yholinocomun/robotfun_ws/src/robotfun_description/meshes/arm/eslabon3_link.stl

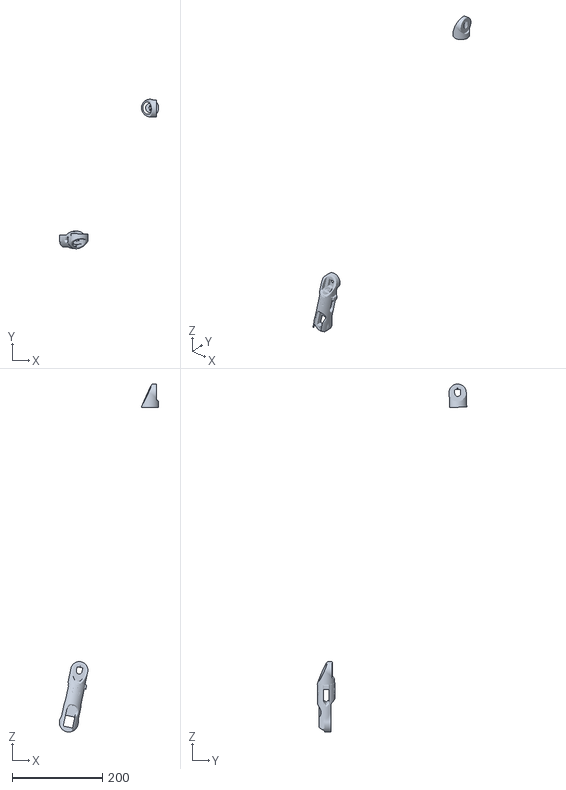
[picture p1: CAD file, 2026-06-30]
src/robotfun_description/meshes/arm/eslabon3_link.stl
219.9 x 331.1 x 770.3
