yholinocomun/robotfun_ws/src/robotfun_description/meshes/gripper/right_gripper.stl

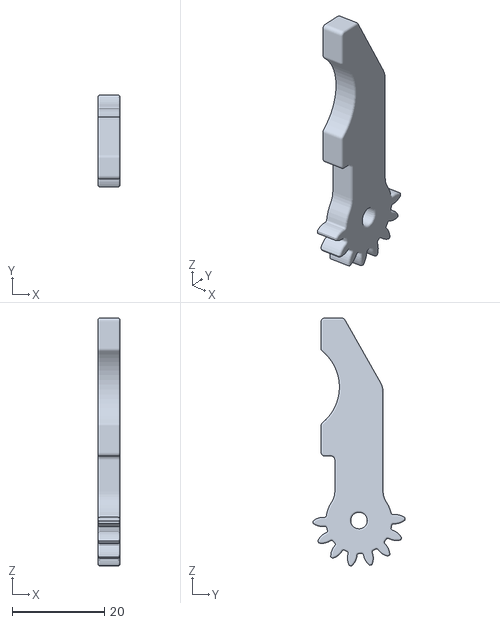
[picture p2: CAD file, 2026-06-30]
src/robotfun_description/meshes/gripper/right_gripper.stl
4.80 x 20.0 x 53.9
