yholinocomun/robotfun_ws/src/robotfun_description/meshes/arm/eslabon4_link.stl

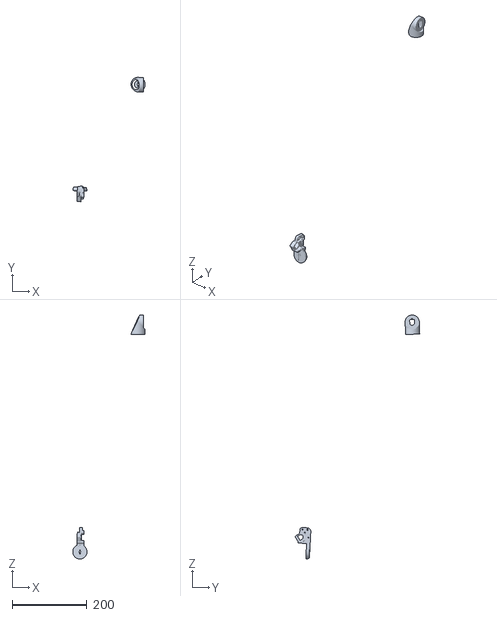
[picture p3: CAD file, 2026-06-30]
src/robotfun_description/meshes/arm/eslabon4_link.stl
193.6 x 332.6 x 651.7
