yholinocomun/robotfun_ws/src/robotfun_description/meshes/arm/base_link.stl

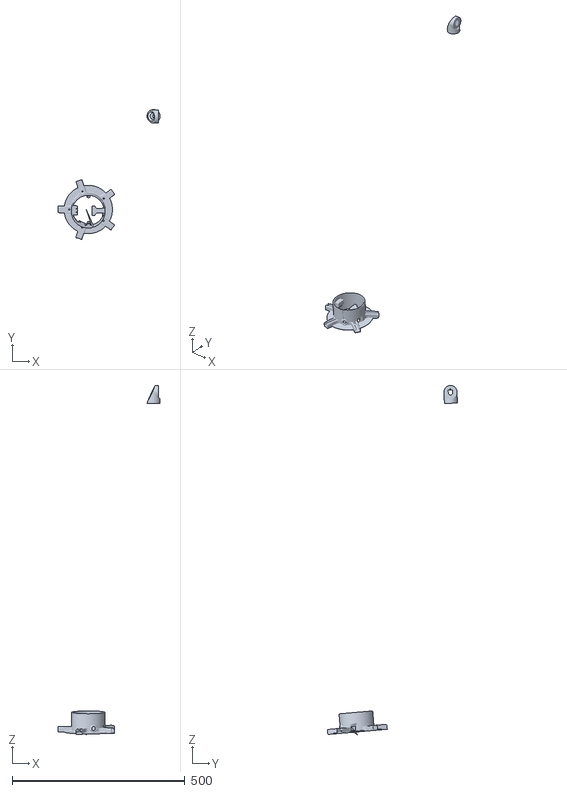
[picture p4: CAD file, 2026-06-30]
src/robotfun_description/meshes/arm/base_link.stl
296.0 x 376.2 x 1010.3
