yholinocomun/robotfun_ws/src/robotfun_description/meshes/arm/eslabon2_link.stl

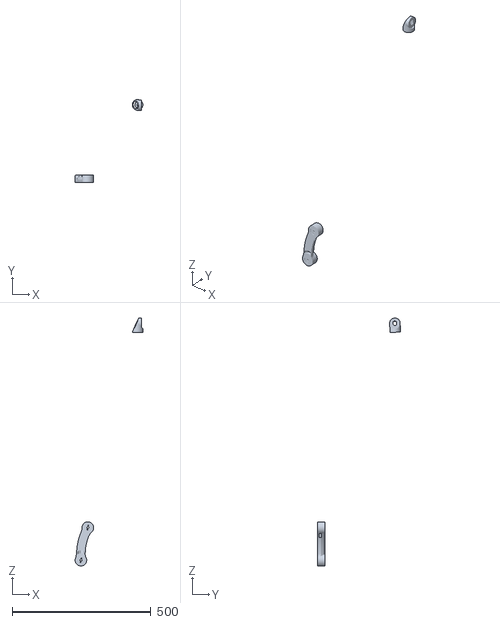
[picture p5: CAD file, 2026-06-30]
src/robotfun_description/meshes/arm/eslabon2_link.stl
244.3 x 299.2 x 894.1
