yholinocomun/robotfun_ws/src/robotfun_description/meshes/arm/eslabon1_link.stl

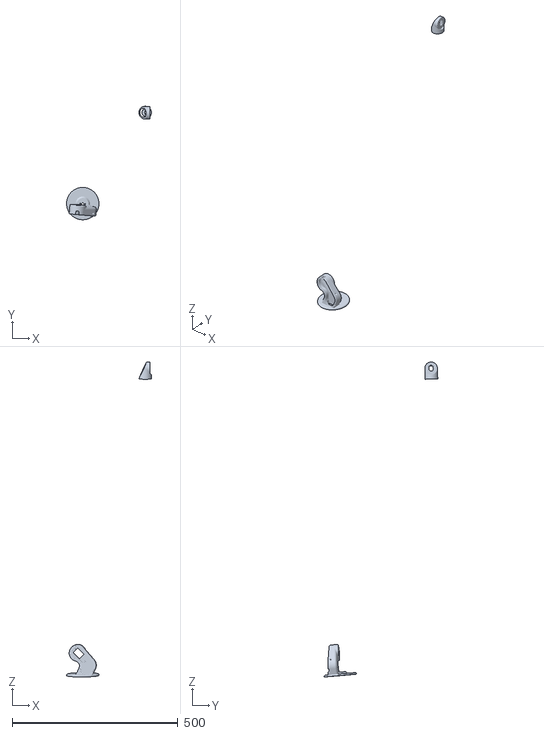
[picture p6: CAD file, 2026-06-30]
src/robotfun_description/meshes/arm/eslabon1_link.stl
256.5 x 343.2 x 951.4
