yholinocomun/robotfun_ws/(list of files, cad)

Other CAD files:
src/robotfun_description/meshes/gripper/left_gripper.stl
