yholinocomun/robotfun_ws/src/robotfun_description/urdf/common/arm.macro.xacro

<?xml version="1.0"?>
<!-- ============================================================================
     arm.macro.xacro  —  esqueleto PRIMITIVO (tabla DH del usuario)
     ===========================================================================
     Brazo 4 GDL RECTO dibujado con PRIMITIVAS dimensionadas a la tabla DH:
         L0=0.010 (offset base)  L1=0.063  L2=0.120  A3=0.120  HAND=0.11  [m]
     Reproduce EXACTAMENTE la FK del núcleo (TF == FK). Es el modelo para
     VERIFICAR el DH y la cinemática inversa.  FK(HOME) → TCP=[0.010, 0, 0.413].

     Ejes: joint_1=(0 0 1) yaw; joint_2/3/4=(0 -1 0) pitch. tool0 = frame (sin cubo).
     ========================================================================== -->
<robot xmlns:xacro="http://www.ros.org/wiki/xacro">

  <xacro:property name="lo" value="-1.5708"/>   <!-- −90° (HOME=0 ⇒ servo a 90°) -->
  <xacro:property name="hi" value="1.5708"/>    <!-- +90° -->

  <xacro:macro name="robotfun_arm">

    <link name="world"/>
    <joint name="base_joint" type="fixed">
      <origin xyz="0 0 0" rpy="0 0 0"/><parent link="world"/><child link="base_link"/>
    </joint>

    <!-- base_link (soporte fijo) -->
    <link name="base_link">
      <inertial><mass value="1.0"/>
        <inertia ixx="0.01" ixy="0" ixz="0" iyy="0.01" iyz="0" izz="0.01"/></inertial>
      <visual>
        <origin xyz="0 0 0.015" rpy="0 0 0"/>
        <geometry><cylinder radius="0.045" length="0.03"/></geometry>
        <material name="grey"/>
      </visual>
    </link>

    <!-- joint_1 yaw (en la base) -->
    <joint name="joint_1" type="revolute">
      <origin xyz="0 0 0" rpy="0 0 0"/><parent link="base_link"/><child link="link_1"/>
      <axis xyz="0 0 1"/><limit lower="${lo}" upper="${hi}" effort="10.0" velocity="1.5"/>
    </joint>

    <!-- link_1: columna de yaw hasta el hombro (L0 radial, L1 alto) -->
    <link name="link_1">
      <inertial><origin xyz="0.005 0 0.032"/><mass value="0.5"/>
        <inertia ixx="1e-3" ixy="0" ixz="0" iyy="1e-3" iyz="0" izz="1e-3"/></inertial>
      <visual>
        <origin xyz="0.005 0 0.032" rpy="0 0.156 0"/>
        <geometry><cylinder radius="0.022" length="0.064"/></geometry>
        <material name="black"/>
      </visual>
    </link>

    <!-- joint_2 hombro: offset radial L0=0.010, alto L1=0.063 -->
    <joint name="joint_2" type="revolute">
      <origin xyz="0.010 0 0.063" rpy="0 0 0"/><parent link="link_1"/><child link="link_2"/>
      <axis xyz="0 -1 0"/><limit lower="${lo}" upper="${hi}" effort="10.0" velocity="1.5"/>
    </joint>

    <!-- link_2: brazo L2=0.120 -->
    <link name="link_2">
      <inertial><origin xyz="0 0 0.06"/><mass value="0.4"/>
        <inertia ixx="1e-3" ixy="0" ixz="0" iyy="1e-3" iyz="0" izz="1e-3"/></inertial>
      <visual>
        <origin xyz="0 0 0.060" rpy="0 0 0"/>
        <geometry><cylinder radius="0.018" length="0.120"/></geometry>
        <material name="red"/>
      </visual>
    </link>

    <joint name="joint_3" type="revolute">
      <origin xyz="0 0 0.120" rpy="0 0 0"/><parent link="link_2"/><child link="link_3"/>
      <axis xyz="0 -1 0"/><limit lower="${lo}" upper="${hi}" effort="10.0" velocity="1.5"/>
    </joint>

    <!-- link_3: antebrazo A3=0.120 -->
    <link name="link_3">
      <inertial><origin xyz="0 0 0.06"/><mass value="0.3"/>
        <inertia ixx="8e-4" ixy="0" ixz="0" iyy="8e-4" iyz="0" izz="8e-4"/></inertial>
      <visual>
        <origin xyz="0 0 0.060" rpy="0 0 0"/>
        <geometry><cylinder radius="0.015" length="0.120"/></geometry>
        <material name="blue"/>
      </visual>
    </link>

    <joint name="joint_4" type="revolute">
      <origin xyz="0 0 0.120" rpy="0 0 0"/><parent link="link_3"/><child link="link_4"/>
      <axis xyz="0 -1 0"/><limit lower="${lo}" upper="${hi}" effort="10.0" velocity="1.5"/>
    </joint>

    <!-- link_4: mano HAND=0.11 (muñeca → punta) -->
    <link name="link_4">
      <inertial><origin xyz="0 0 0.055"/><mass value="0.2"/>
        <inertia ixx="5e-4" ixy="0" ixz="0" iyy="5e-4" iyz="0" izz="5e-4"/></inertial>
      <visual>
        <origin xyz="0 0 0.055" rpy="0 0 0"/>
        <geometry><cylinder radius="0.013" length="0.110"/></geometry>
        <material name="black"/>
      </visual>
    </link>

    <!-- tool0 = TCP (punta del gripper). Solo frame, sin cubo. -->
    <joint name="tool_fixed" type="fixed">
      <origin xyz="0 0 0.110" rpy="0 0 0"/><parent link="link_4"/><child link="tool0"/>
    </joint>
    <link name="tool0"/>

  </xacro:macro>
</robot>
