yholinocomun/robotfun_ws/src/robotfun_description/urdf/common/gripper.macro.xacro

<?xml version="1.0"?>
<!-- ============================================================================
     gripper.macro.xacro
       * gripper_primitive : gripper de 1 GDL con dedos finos de caja; se mueve con
         el joint "joint_5" (el 5º actuador, físicamente el gripper) para el modelo
         de medidas reales. Sin el cubo anterior.
     ========================================================================== -->
<robot xmlns:xacro="http://www.ros.org/wiki/xacro">

  <!-- ===== PRIMITIVO (móvil) ===== -->
  <xacro:macro name="gripper_primitive" params="parent *origin">
    <joint name="joint_5" type="revolute">
      <xacro:insert_block name="origin"/>
      <parent link="${parent}"/><child link="gripper_finger_left"/>
      <axis xyz="0 1 0"/>
      <!-- rango 0..70° (1.22 rad), igual que el firmware/command; asi RViz no recorta -->
      <limit effort="5.0" lower="0.0" upper="1.22" velocity="2.0"/>
    </joint>
    <link name="gripper_finger_left">
      <inertial><mass value="0.01"/>
        <inertia ixx="1e-6" ixy="0" ixz="0" iyy="1e-6" iyz="0" izz="1e-6"/></inertial>
      <visual>
        <origin xyz="0.012 0 0.018" rpy="0 0 0"/>
        <geometry><box size="0.006 0.012 0.036"/></geometry>
        <material name="red"/>
      </visual>
    </link>
    <joint name="joint_5_right" type="revolute">
      <xacro:insert_block name="origin"/>
      <parent link="${parent}"/><child link="gripper_finger_right"/>
      <axis xyz="0 1 0"/>
      <limit effort="5.0" lower="-1.22" upper="0.0" velocity="2.0"/>
      <mimic joint="joint_5" multiplier="-1.0"/>
    </joint>
    <link name="gripper_finger_right">
      <inertial><mass value="0.01"/>
        <inertia ixx="1e-6" ixy="0" ixz="0" iyy="1e-6" iyz="0" izz="1e-6"/></inertial>
      <visual>
        <origin xyz="-0.012 0 0.018" rpy="0 0 0"/>
        <geometry><box size="0.006 0.012 0.036"/></geometry>
        <material name="red"/>
      </visual>
    </link>
  </xacro:macro>

</robot>
