yholinocomun/robotfun_ws/(commit log)

2026-05-17 creando . urdf y .launch del robotfun
    [robotfun.urdf]
2026-06-30 robotfun_kinematics: núcleo DH puro + nodos ROS (IK J4 fijo/activo)
    Núcleo sin ROS (Clean Architecture):
    - core/dh_model.py: tabla DH validada (FK(HOME)=[0.010,0,0.393]), FK, Jacobiano
    geométrico 6x5. DHChain encapsula la tabla (SOLID).
    - core/ik_solver.py: IK por DLS (Levenberg-Marquardt) con máscara de juntas
    activas. Una sola implementación cubre las DOS versiones: J4 fijo (4 GDL,
    pick&place, bien condicionada) y J4 activo (5 GDL). Utilidades de orientación.
    - core/trajectory.py: perfil trapezoidal (servos de posición, lazo abierto).
    Nodos ROS (adaptadores delgados):
    - ik_node: /target_pose -> IK -> /joint_command (param use_joint4).
    - fk_check_node: /joint_states -> FK -> /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
2026-06-30 robotfun_description: brazo 5 GDL + gripper (primitivas DH-exactas y meshes reales)
    Reemplaza el placeholder (robot móvil) por el brazo real. Dos modelos sin
    conflicto, misma interfaz de juntas (joint_1..joint_5 + gripper):
    - robotfun.urdf.xacro (CANÓNICO): generado desde la tabla DH validada con
    scripts/generate_dh_origins.py; verificado TF == FK a 1e-6 sobre el URDF
    expandido. Incluye <collision> e <inertial> (listo para Gazebo/MoveIt2).
    - robotfun_meshes.urdf.xacro: repara el brazo.urdf original (renombra juntas,
    elimina engranajes con meshes inexistentes y rpy en grados, satura límites a
    ±90°) y monta el gripper real rescatado de twin_ws.
    - common/: materials.xacro y grippe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
    [base_link.stl, eslabon1_link.stl, eslabon2_link.stl, eslabon3_1link.stl, eslabon3_link.stl, eslabon4_link.stl, gripper.macro.xacro, joint_limits.yaml]
2026-06-30 robotfun_firmware: ESP32 micro-ROS 5 GDL + gripper (dos versiones por #define)
    Refactor del firmware base con buenas prácticas:
    - #define USE_JOINT4 1|0: una sola base de código, dos versiones (DRY). 1 = J4
    activo (5 GDL); 0 = J4 anulado (servo de J4 fijo en HOME, q4=0, 4 GDL para
    pick&place). Gemelo del parámetro use_joint4 del alto nivel.
    - Radianes en el bus ROS (REP-103); conversión a grados solo en servo.write().
    Calibración expresada en grados/ADC (intuitiva del hardware).
    - Rango articular POR CANAL (el gripper usa su propio rango, ya no ±90° global).
    - Estructura clara, utilidades clampf/adc_to_rad/rad_to_servo_deg, nombres de
    junta consistentes con el URDF y el núcle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
2026-06-30 robotfun_bringup + README: composition root y documentación de arquitectura
    - launch/bringup.launch.py: compone descripción + cinemática (args model,
    use_joint4, controller, gui).
    - docs/ARCHITECTURE.md: capas (Clean Architecture/SOLID), flujo de datos, modelo
    DH, y las decisiones técnicas (J4 fijo por defecto; radianes en bus/grados en
    servo; control trapezoidal). Documenta la inconsistencia DH<->URDF de twin_ws
    ya corregida aquí.
    - docs/ROADMAP.md: fases hacia el pick&place con cámara (Gazebo, MoveIt2,
    percepción QR/color) sin romper la fuente de verdad.
    - README del workspace con guía de uso y las respuestas a J4 y grados/radianes.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
2026-06-30 fix(description): envolver robot_description en ParameterValue(value_type=str)
    En ROS 2 Humble, pasar la salida de `xacro` (Command) directamente como
    parámetro hace que launch intente parsear el XML como YAML y falle con
    "Unable to parse the value of parameter robot_description as yaml".
    Se envuelve en launch_ros ParameterValue(..., value_type=str). Afecta a
    display.launch.py (y por tanto a bringup.launch.py que lo incluye).
    Claude-Session: https://claude.ai/code/session_01HQm53DmrqYUT2G9sJ8qfUh
2026-06-30 robotfun_kinematics: rediseño a 4 GDL (IK analítica + numéricas + workspace)
    Se elimina el roll (antiguo joint_4); el antiguo joint_5 pasa a joint_4. El brazo
    queda yaw+3·pitch, que admite IK ANALÍTICA CERRADA.
    - core/dh_model.py: tabla DH 4 GDL derivada de las medidas reales (brazo_ws).
    FK(HOME) reproduce las posiciones de junta del URDF (hombro/codo/muñeca).
    - core/ik_solver.py: IK analítica cerrada (yaw=atan2 + 2R planar, ambas ramas de
    codo, elige por cercanía a la semilla) + métodos numéricos: DLS (Levenberg-
    Marquardt), Newton (Gauss-Newton) y gradiente (Jacobiano transpuesto). Tarea =
    posición + ángulo de aproximación φ; error angular envuelto a [-π,π].
    - core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
2026-06-30 robotfun_description: brazo 4 GDL, esqueleto único (medidas reales + piezas reales)
    - urdf/common/arm.macro.xacro: esqueleto compartido con los orígenes REALES de
    brazo_ws y los pitch en axis="0 -1 0" → reproduce EXACTAMENTE la FK del núcleo
    (TF==FK a 1e-16). Param use_mesh selecciona primitivas o meshes.
    - robotfun.urdf.xacro: MEDIDAS REALES (primitivas) — para verificar la IK.
    - robotfun_meshes.urdf.xacro: PIEZAS REALES (meshes del CAD, ya limpias) + gripper
    real de twin_ws. Misma interfaz de juntas que el primitivo → mismo /joint_states.
    - Limpieza: eliminado eslabon3_1link.stl (pieza sobrante); corregida la escala de
    eslabon3 (0.001 → 0.0001; a 0.001 flotaba a ~2.4 m).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
    [arm.macro.xacro, eslabon3_1link.stl, joint_limits.yaml, robotfun.urdf.xacro, robotfun_meshes.urdf.xacro]
2026-06-30 robotfun_firmware: 4 juntas + gripper (roll eliminado, servo muerto a 90°)
    - 5 canales [joint_1..joint_4, gripper]; el roll (antiguo joint_4) se elimina y
    su servo, si sigue montado, se mantiene fijo a 90° (DEAD_ROLL_PIN, -1 si ya no).
    - Pines remapeados: j4 toma el pin del antiguo j5 (servo 19 / pot 27).
    - /joint_command espera [q1..q4, gripper] (acepta >=4); /joint_states a 25 Hz.
    - Radianes en el bus; conversión a grados solo en servo.write(); calibración por
    canal en grados/ADC. README actualizado.
    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
2026-06-30 robotfun_bringup + README: 4 GDL, métodos de IK y restricción de área de trabajo
    - bringup.launch.py: args model / controller / method / approach_deg / gui (4 GDL).
    - docs/ARCHITECTURE.md: modelo DH 4 GDL, tabla de métodos de IK (analítica vs
    numéricas) y sección de workspace. ROADMAP a 4 GDL.
    - README: guía de uso, métodos de IK y CÓMO RESTRINGIR EL ÁREA DE TRABAJO para la
    IK y el pick & place (caja x/y/z + alcance + altura mínima, vía parámetros).
    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
2026-06-30 4 GDL: brazo recto con medidas reales, gripper fusionado y sin cubo
    Cambios pedidos por el usuario (con sus medidas reales):
    - Medidas: antebrazo A3=0.125 m y mano HAND=0.12 m (medidas del usuario). Se
    adopta un brazo RECTO (sin el offset de 17°): DH más limpia y verificable.
    FK(HOME) → TCP=[0,0,0.5102]; TF==FK a 1e-16 (verify_kinematics.py).
    - Restricción articular literal −90/0/+90 (HOME=0 ⇒ servo a 90°): es la que ya
    estaba; se confirma en límites del URDF y del núcleo.
    - URDF de hardware (model:=meshes): tool0 deja de tener cubo (solo frame); el
    gripper real (twin_ws) se FUSIONA a link_4 como un solo cuerpo rígido
    (gripper_mesh_fused), sin piezas flotando. Mallas r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
    [arm.macro.xacro, gripper.macro.xacro, robotfun.urdf.xacro, robotfun_meshes.urdf.xacro]
2026-06-30 Aplicar tabla DH del usuario (L0..L5) y limpiar el modelo de meshes
    Medidas según la tabla DH del usuario (brazo_ws actualizado):
    L0=0.010 (offset radial base), L1=0.063, L2=0.120, A3=L3+L4=0.120, HAND=L5=0.11.
    FK(HOME) → TCP=[0.010, 0, 0.413]. La IK analítica considera el offset de hombro
    L0. Restricción articular −90/0/+90 (HOME=0 ⇒ servo a 90°).
    - Modelo PRIMITIVO (model:=primitives): esqueleto de la tabla DH, reproduce
    EXACTAMENTE la FK (TF==FK a 1e-16). Es la referencia para verificar la IK.
    - Modelo de MESHES (model:=meshes): standalone con los orígenes del CAD
    (brazo.urdf, donde las mallas se alinean), mismas juntas joint_1..joint_4 y
    sentidos de giro (axis 0 -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
    [arm.macro.xacro, eslabon3_link.stl, gripper.macro.xacro, robotfun.urdf.xacro, robotfun_meshes.urdf.xacro]
2026-06-30 Arreglar conflicto de /joint_states en RViz (relay de simulación + modos)
    El temblor/bucle en RViz se debía a DOS fuentes de /joint_states a la vez
    (sliders del display + joint_state_publisher del bringup), y a que en simulación
    nadie convertía /joint_command en /joint_states (el robot no seguía a la IK).
    - Nuevo nodo robotfun_kinematics joint_state_relay (ESP32 virtual): reenvía
    /joint_command → /joint_states. Cierra la cadena IK→RViz sin hardware.
    - bringup.launch.py reestructurado con argumento `mode` que garantiza UNA sola
    fuente de /joint_states:
    sim → joint_state_relay + cinemática (el robot sigue a la IK)
    gui → joint_state_publisher_gui (sliders),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
2026-07-01 Firmware: centro de servo por junta (para ampliar el espacio de trabajo)
    - robotfun_esp32_microros.ino: SERVO_CENTER_DEG pasa a ser POR CANAL. El servo da
    180° físicos; el centro decide cómo se reparten (±90 simétrico, o asimétrico
    para más rango hacia adelante). Documentado el procedimiento (re-montar horn +
    recalibrar RAW_ZERO + ajustar Q_MIN/MAX en la cinemática). Default sigue
    simétrico (90 / ±90) para no romper la calibración actual.
    - dh_model.py: Q_MIN_DEG/Q_MAX_DEG por junta (deben coincidir con el firmware),
    con ejemplo asimétrico documentado. FK(HOME) intacta.
    Claude-Session: https://claude.ai/code/sessi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
2026-07-01 firmware: sketch de calibración RAW del HOME (robotfun_calibracion_raw.ino)
    Sketch auxiliar (sin micro-ROS) que imprime el ADC crudo de los 5 pots por el
    Monitor Serie, para fijar RAW_ZERO[] del firmware principal con el brazo en HOME.
    Resuelve el desfase observado (los pots reportaban ~[-49,-11,-35]° en reposo en
    vez de 0).
    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
2026-07-04 Reestructura a 5 actuadores joint_1..joint_5 (joint_5 = gripper) + reasigna pines
    Reorganiza el proyecto como si el robot siempre hubiese tenido 5 actuadores
    (sin el antiguo roll de muñeca): joint_4 = pitch de muñeca, joint_5 = gripper.
    Firmware (robotfun_esp32_microros.ino):
    - joint_name_buf / JOINT_LABEL = joint_1..joint_5 (gripper renombrado a joint_5).
    - Reasigna pines tras quitar el roll: POT revive 35 (joint_4), continúa 27
    (gripper) y anula 26 -> {32,33,34,35,27}; SERVO revive 18, continúa 19 y
    anula 21 -> {2,4,5,18,19}. Documenta que solo los pines de pot fueron fijados
    explícitamente por el usuario.
    - Elimina el servo muerto de roll (DEAD_ROLL_PIN) y su bloque; ya no exi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
    [gripper.macro.xacro, joint_limits.yaml]
2026-07-04 Firmware: movimiento suave con perfil trapezoidal por junta (todos los servos)
    El ESP32 ya no salta al objetivo al recibir /joint_command. Ahora guarda el
    objetivo y un perfil trapezoidal por junta (velocidad + aceleracion limitadas)
    lleva cada servo al objetivo en pasos de 20 ms (50 Hz, igual que el PWM).
    - Ley por tick, re-planificada (admite objetivos nuevos a mitad de trayecto):
    v_stop = sqrt(2*a_max*|err|); v_des = sign(err)*min(v_max,v_stop);
    v += clamp(v_des-v, ±a_max*dt); pos += v*dt; write(pos).
    - Limites por junta MAX_VEL/MAX_ACC (rad/s, rad/s^2), coherentes con
    config/joint_limits.yaml y por encima de los del trajectory_node.
    - command_callback solo fija target_pos (no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
2026-07-04 Firmware: rompe el bucle "ida y vuelta a HOME" por reset (brownout) + diagnostico
    El brazo que va al angulo y regresa solo a HOME en bucle no es el firmware (es
    lazo abierto: llega y se queda), sino que el ESP32 se RESETEA (tipicamente
    brownout por el pico de corriente de los servos) y en cada setup() re-homeaba.
    - Persistencia en memoria RTC (RTC_DATA_ATTR): guarda el ultimo objetivo, que
    sobrevive a un reset por brownout. Al arrancar RESTAURA ese objetivo en vez de
    forzar HOME -> el brazo se queda donde estaba y deja de rebotar; ademas reduce
    el pico de corriente del arranque.
    - Diagnostico por ROS sin cables extra: /joint_states.effort[0]=boot_count (sube
    solo => hay resets) y ef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
    [robotfun_esp32_microros.ino]
2026-07-04 Firmware: movimiento suave sobre la base micro-ROS que funciona (sin RTC, con delay(1))
    El bucle "ida y vuelta a HOME" venia de la version anterior (perfil + memoria RTC
    + loop sin delay), no de la base. La version de salto directo del usuario NO hace
    bucle, asi que se descarta brownout como causa principal: el culpable probable era
    el reset por watchdog al quitar el delay(1) del loop.
    Este firmware parte EXACTO de esa base que funciona y solo anade el suavizado:
    - command_callback fija target_pos (rad); no escribe el servo de golpe.
    - update_motion (perfil trapezoidal por junta, arranca/frena suave) a 50 Hz;
    solo escribe el servo mientras se mueve (patron del sketch de referencia).
    - loo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
    [robotfun_esp32_microros.ino]
2026-07-04 Firmware: porta el suavizado de tu sketch (rampa lineal enteros) a micro-ROS
    Toma como base el sketch robotfun_ultra_ligero_veloz (que ya da movimiento suave
    y no hace bucle) y lo porta a micro-ROS. Cambios frente a la version anterior:
    - Suavizado = rampa lineal con MATEMATICA DE ENTEROS (centigrados) y
    writeMicroseconds, exactamente el metodo del sketch de referencia. Solo escribe
    el servo cuando se mueve.
    - Entrada por /joint_command en RADIANES (antes era Serial en grados): se convierte
    rad -> centigrados y se fija el objetivo; la rampa lo alcanza suave @50 Hz.
    - Se conserva el feedback de potenciometros -> /joint_states (para RViz) y la
    calibracion confirmada (RAW_ZERO, FEEDBAC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
2026-07-04 Firmware DEFINITIVO: movimiento fluido con tarea de tiempo real (FreeRTOS core 0)
    El "a pasitos" venia de correr el suavizado dentro de loop() junto a micro-ROS:
    spin_some() bloquea irregular => pasos desiguales. Solucion (reestructuracion):
    - El movimiento se ejecuta en una TAREA FreeRTOS dedicada, pineada al nucleo 0,
    con temporizacion EXACTA (vTaskDelayUntil @50 Hz). Inmune al jitter de micro-ROS
    (que queda solo en loop(), nucleo 1) => movimiento FLUIDO.
    - Perfil TRAPEZOIDAL por junta (arranque/frenado gradual) en grados/s y grados/s^2,
    con resolucion fina en microsegundos (float) => sin pasos de 1 grado.
    - Deteccion de cruce del objetivo: fija exacto y para => overshoot 0 y sin ji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
    [robotfun_esp32_microros.ino]
2026-07-04 Firmware: arregla el reset del ESP32 (stack overflow de la tarea de servo)
    La trayectoria fluida era correcta, pero el ESP32 se reseteaba. Causa: la tarea
    FreeRTOS de servo se creaba con pila de 4096 bytes, insuficiente para el perfil
    float (sqrtf/fminf) + las llamadas a la libreria de servos -> desbordaba la pila
    (stack canary) -> reset. No era brownout (la version de salto directo, con el pico
    de corriente mayor, no se reseteaba).
    Arreglo:
    - Pila de la tarea a 8192 bytes.
    - Tarea en el NUCLEO 1 (mismo que attach(): evita choques de LEDC entre nucleos y
    deja el nucleo 0 libre para el sistema/watchdog IDLE0).
    - Prioridad 3 (> loop): preempta a loop() cada 20 ms => temporizacion exacta =>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
    [robotfun_esp32_microros.ino]
2026-07-04 Firmware ROBUSTO: elimina la tarea FreeRTOS (causa del reset), suavizado en loop()
    El reset persistia con la tarea FreeRTOS aunque se subiera la pila => la tarea en
    si era el problema. Version mas robusta: SIN tarea, todo en loop() (un solo hilo),
    igual que las versiones que nunca se reseteaban.
    - Perfil trapezoidal por junta en float con paso cada 20 ms exactos (micros()).
    - Fluidez por PASOS FINOS en microsegundos (float) + deteccion de cruce (0
    overshoot); escribe el servo solo cuando el PWM cambia.
    - Sin FreeRTOS, sin RTC, sin volatile; loop() cede CPU con delay(1).
    - Arranque de servos ESCALONADO (delay entre attach) para no pedir toda la
    corriente de golpe (reduce riesgo de browno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
    [robotfun_esp32_microros.ino]
2026-07-04 Añade nodo pick_place: secuencia automática de pick & place en un solo nodo
    Nuevo nodo robotfun_kinematics/nodes/pick_place_node.py que ejecuta la secuencia
    completa de pick & place publicando objetivos articulares [q1..q4,gripper] en
    /joint_command (el firmware del ESP32 hace el movimiento suave). Control directo
    por juntas con los angulos que el usuario valido a mano.
    - Waypoints y secuencia en secciones claras arriba del archivo: facil añadir/editar
    puntos. Cada paso = (nombre, [q1..q4,gripper], espera_segundos).
    - PICK (joint_1=+1.57): encima -> bajar -> cerrar pinza (0.30) -> levantar.
    PLACE (joint_1=-1.57): encima -> bajar -> abrir pinza (0.70) -> subir -> HOME.
    - Parametros: c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
2026-07-04 pick_place: pausa de 2 s antes de agarrar y de soltar (mejor visibilidad)
    Se añade un tipo de paso PAUSA (waypoint = None): el nodo solo espera, sin mover
    el brazo. Se insertan dos pausas de 2.0 s:
    - antes de AGARRAR (tras bajar a la pieza),
    - antes de SOLTAR (tras bajar al destino),
    para que el pick & place se vea claro. Documentado como opcion para añadir pausas
    donde se quiera.
    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
2026-07-04 Firmware: diagnostico de reset en /joint_states.effort (boot_count + motivo)
    El usuario seguia flasheando el commit 34b1466 (tarea FreeRTOS, pila 4096) que se
    resetea. El repo ya tiene la version robusta de un solo hilo (misma logica suave,
    sin tarea). Se le anade un diagnostico para confirmar de una vez si el reset
    restante es por brownout:
    - effort[0] = boot_count (en memoria RTC): si sube solo, el ESP32 se resetea.
    - effort[1] = esp_reset_reason(): 1=power-on, 6=task-WDT, 9=BROWNOUT.
    Visible con 'ros2 topic echo /joint_states' (no necesita monitor serie ni cables).
    La logica de movimiento suave (trapezoidal, pasos finos en us, deteccion de cruce)
    y el resto quedan igual. DISABLE_BROWNOU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
    [robotfun_esp32_microros.ino]
2026-07-04 Firmware definitivo: tarea FreeRTOS suave (como la que gusta) + robusto (no reset)
    El usuario confirma que la version de un solo hilo NO logra el movimiento fluido en
    su hardware (el jitter de micro-ROS en loop() lo hace "a pasitos"); la fluidez viene
    de la temporizacion EXACTA de la tarea FreeRTOS (vTaskDelayUntil). Asi que se vuelve
    a la tarea (misma logica suave) pero endurecida contra el reset:
    - Pila de la tarea 4096 -> 8192 (la de 4096 desbordaba -> reset -> re-home; era el
    "hace 2 posiciones y vuelve a HOME"). Comprueba xTaskCreate != pdPASS.
    - Arranque de servos ESCALONADO (delay entre attach) -> menos pico de corriente.
    - Diagnostico en /joint_states.effort: effort[0]=boot_count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
    [robotfun_esp32_microros.ino]
2026-07-04 Firmware: trim/offset por servo (SERVO_OFFSET_DEG) sobre la version suave+robusta
    Anade un parametro por servo SERVO_OFFSET_DEG[NUM_CH] (grados, por defecto 0) que
    se suma en deg_to_us: servo_deg = CENTER + OFFSET + DIR*q_deg. Permite ajustar el
    HOME fino de cada servo sin tocar el centro ni recalibrar los pots.
    Mantiene todo lo demas: tarea FreeRTOS suave (nucleo 0, vTaskDelayUntil, perfil
    trapezoidal, deteccion de cruce), pila 8192 (no reset), arranque escalonado,
    diagnostico en /joint_states.effort, y todos los parametros por servo (direccion,
    centro, limites) y la calibracion de pots.
    Claude-Session: https://claude.ai/code/sessio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
    [robotfun_esp32_microros.ino]
2026-07-04 URDF: amplia limite del gripper (joint_5) a 0..1.22 rad para RViz
    El comando abre el gripper a 0.70 rad pero el URDF lo topaba a 0.6 -> RViz
    recortaba el dedo. Se amplia joint_5 a [0, 1.22] y su mimic joint_5_right a
    [-1.22, 0], igual que el rango del firmware (0..70 grados) y joint_limits.yaml.
    Asi RViz refleja el gripper completo al sincronizar con el pick & place.
    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
    [gripper.macro.xacro]
